maxx3105/HBW-IO-12-FM/Pictures/HBW-IO-12-FM_Bottom.png

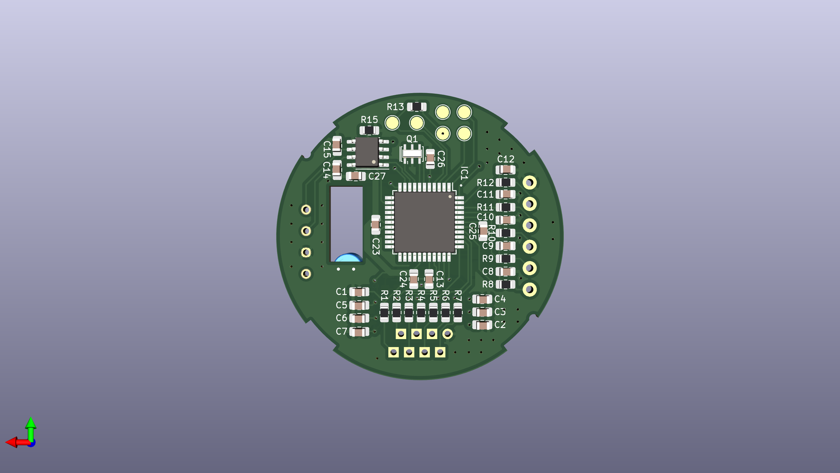
Pictures/HBW-IO-12-FM_Bottom.png
