maxx3105/HBW-IO-12-FM/README.md

# HBW-IO-12-FM
Homematic Wired Modul mit 12 Ein- oder Ausgängen
