maxx3105/HBW-IO-12-FM/Pictures/20240313_112604.jpg

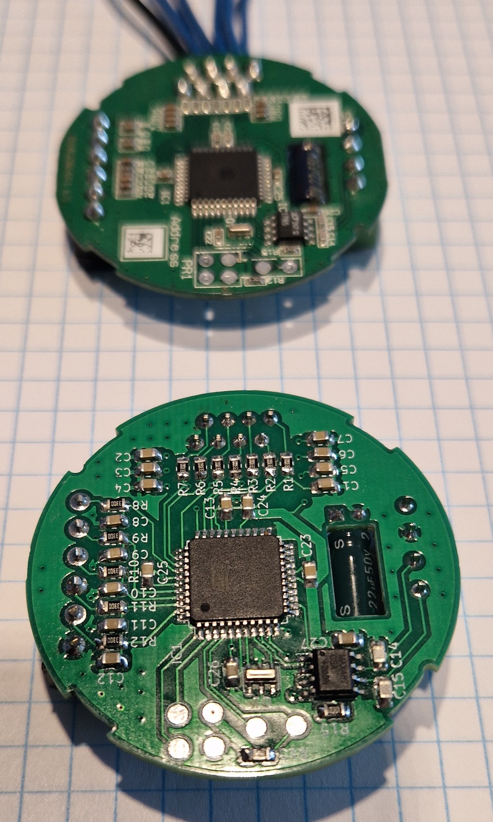
Pictures/20240313_112604.jpg
