maxx3105/HBW-IO-12-FM/Case/HBW-IO-12-FM_Cover.stl

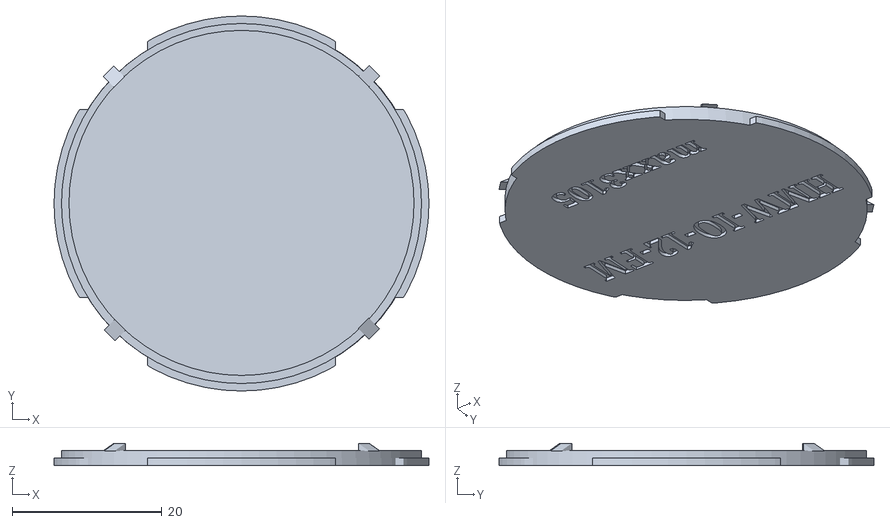
[picture p4: CAD file, 2024-02-26]
Case/HBW-IO-12-FM_Cover.stl
50.0 x 50.0 x 3.00
