maxx3105/HBW-IO-12-FM/Case/HBW-IO-12-FM_Body.stl

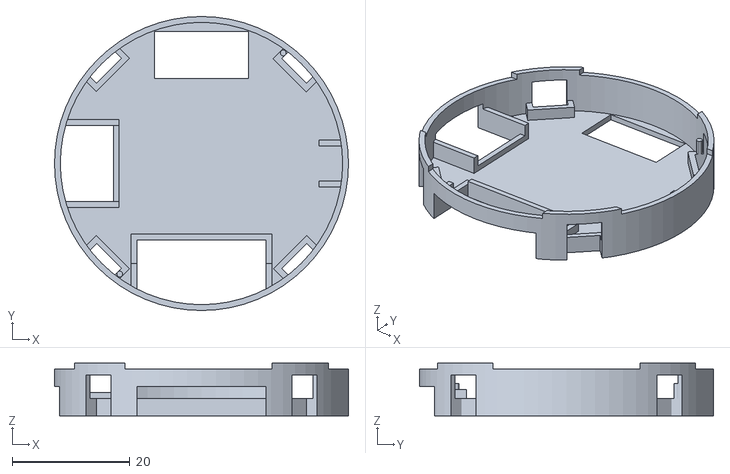
[picture p5: CAD file, 2024-02-26]
Case/HBW-IO-12-FM_Body.stl
50.0 x 50.0 x 9.00
