maxx3105/HBW-IO-12-FM/HBW-IO-12-FM.pdf

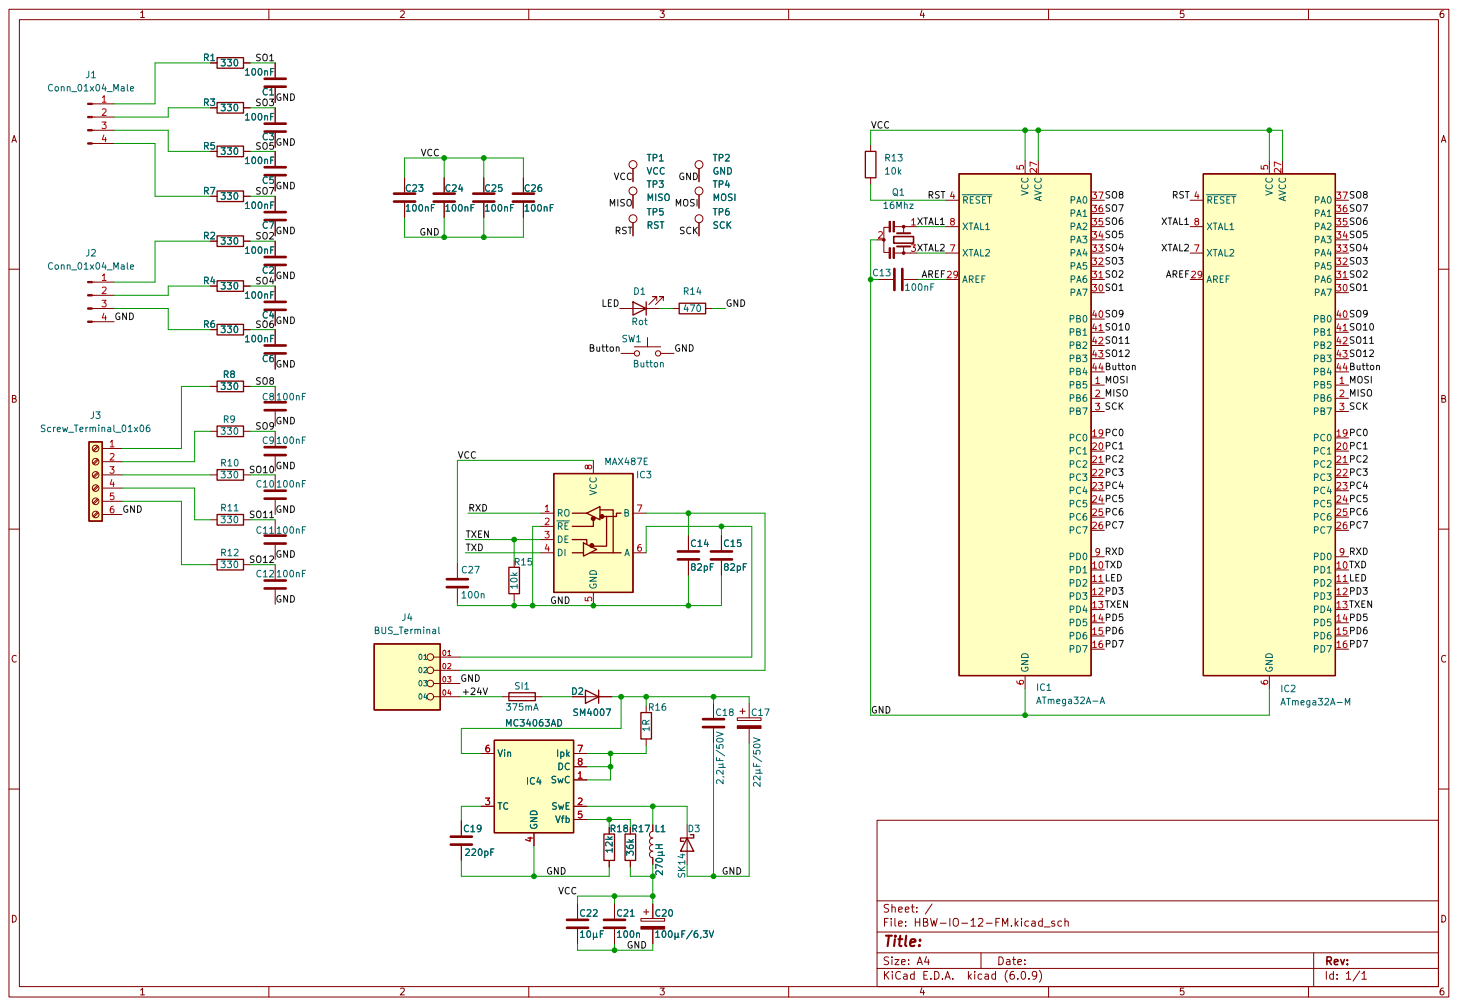
[picture p6: page 1]

File: HBW-IO-12-FM.kicad_sch Sheet: /
