maxx3105/HBW-IO-12-FM/HBW-IO-12-FM.kicad_pcb

## KiCad design HBW-IO-12-FM.kicad_pcb (2024-03-30)

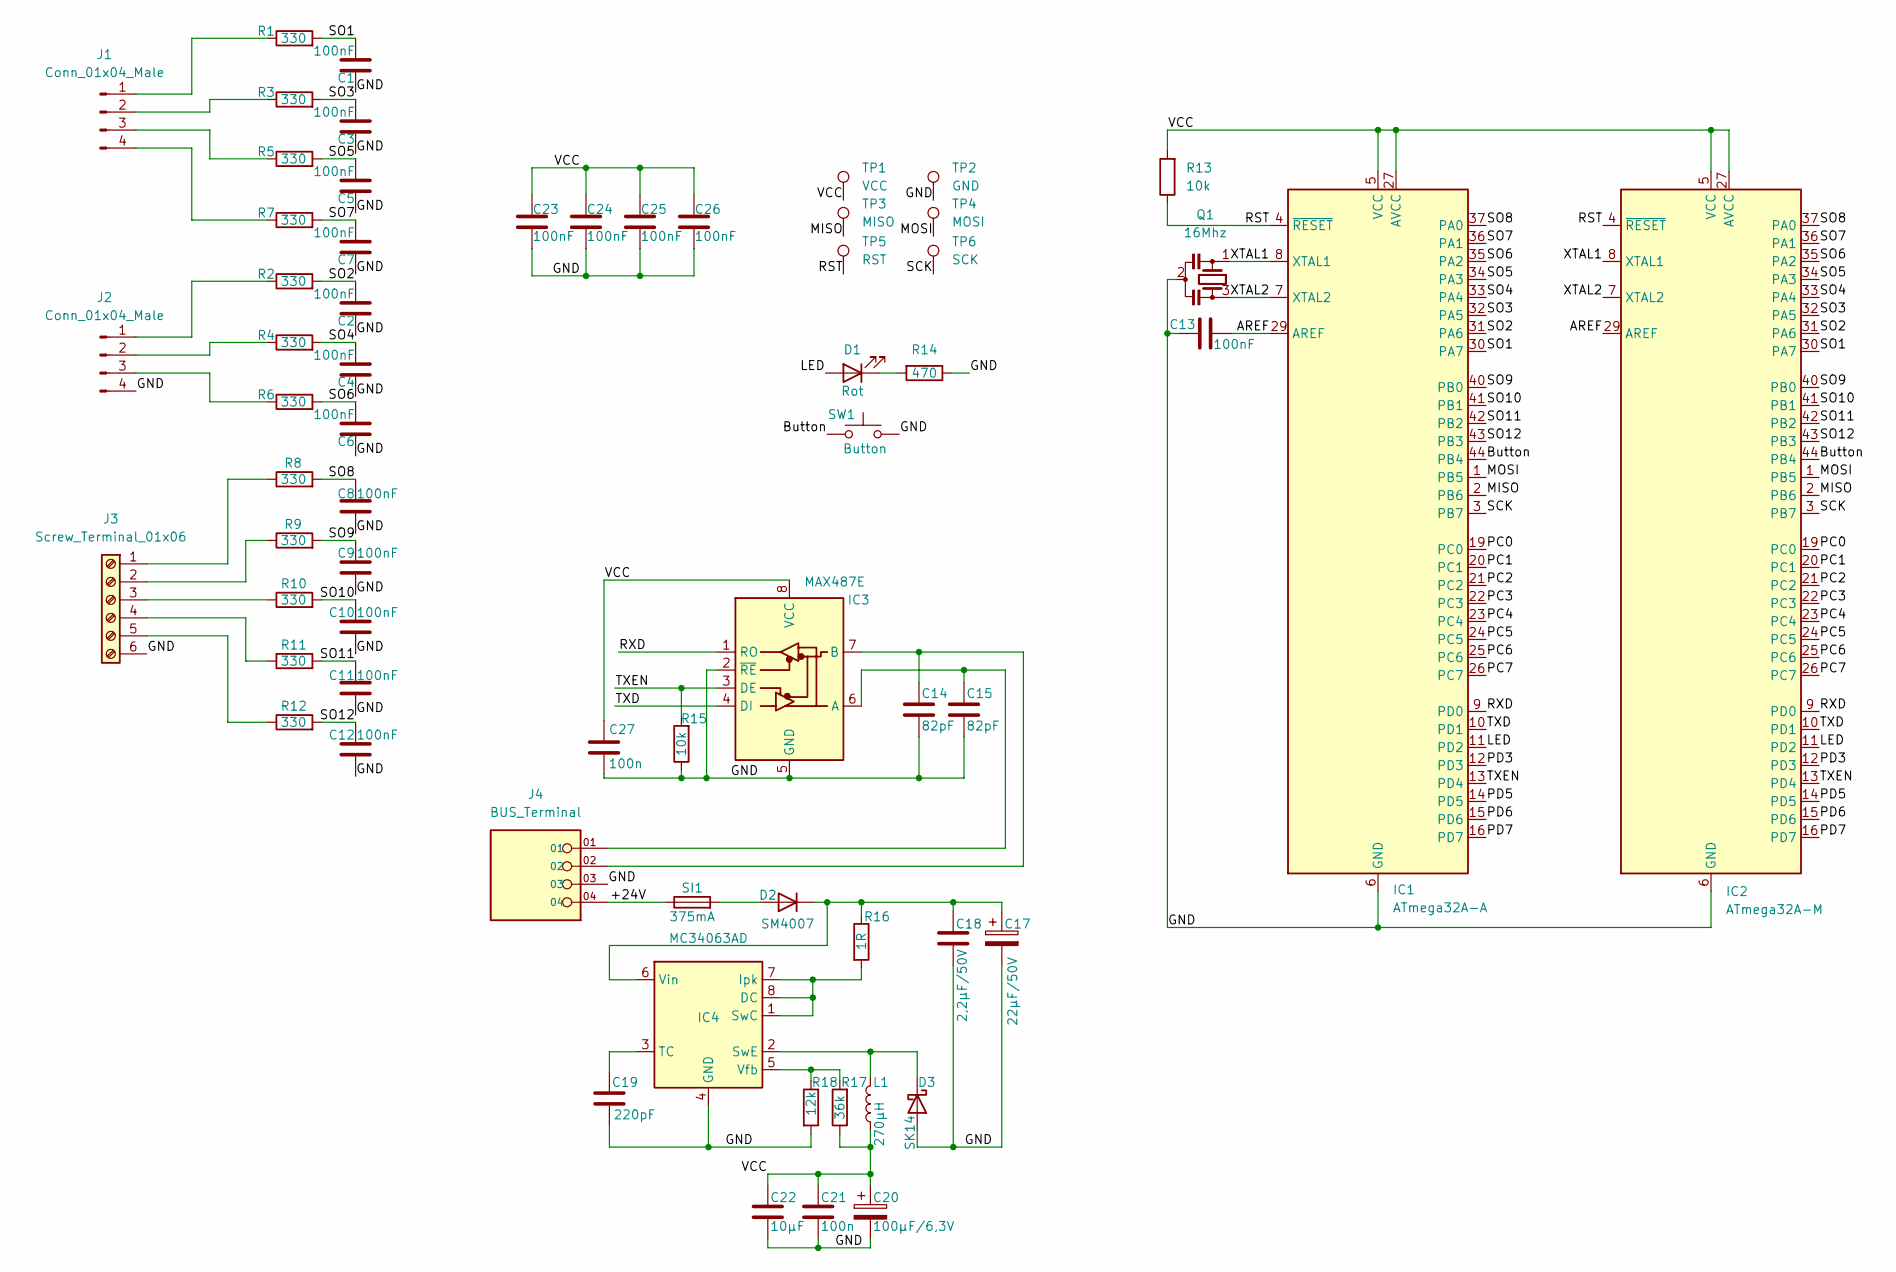
[picture p7: schematic HBW-IO-12-FM.kicad_sch]

Parts:
C1, C2, C3, C4, C5, C6, C7, C8, C9, C10, C11, C12, C13, C23, C24, C25, C26: 100nF; C_0805_2012Metric_Pad1.18x1.45mm_HandSolder
C14, C15: 82pF; C_0805_2012Metric_Pad1.18x1.45mm_HandSolder
C17: 22µF/50V; CP_Radial_D5.0mm_P2.50mm
C18: 2,2µF/50V; C_1210_3225Metric_Pad1.33x2.70mm_HandSolder
C19: 220pF; C_0805_2012Metric_Pad1.18x1.45mm_HandSolder
C20: 100µF/6,3V; CP_EIA-7343-20_Kemet-V_Pad2.25x2.55mm_HandSolder
C21, C27: 100n; C_0805_2012Metric_Pad1.18x1.45mm_HandSolder
C22: 10µF; C_1210_3225Metric_Pad1.33x2.70mm_HandSolder
D1: Rot; LED_0805_2012Metric_Pad1.15x1.40mm_HandSolder
D2: SM4007; D_MELF
D3: SK14; D_MELF
IC1: ATmega32A-A; TQFP-44_10x10mm_P0.8mm
IC2: ATmega32A-M; QFN-44-1EP_7x7mm_P0.5mm_EP5.2x5.2mm
IC3: MAX487E; SOIC-8_3.9x4.9mm_P1.27mm
IC4: MC34063AD; SOIC-8_3.9x4.9mm_P1.27mm
J1, J2: Conn_01x04_Male; PinHeader_1x04_P2.54mm_Vertical
J3: Screw_Terminal_01x06; TerminalBlock_MetzConnect_Type059_RT06306HBWC_1x06_P3.50mm_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
J4: BUS_Terminal; PHOENIX_1891085; PARTREV 11.03.2015
L1: 270µH; L_Taiyo-Yuden_MD-4040
Q1: 16Mhz; Resonator_SMD_Murata_CSTxExxV-3Pin_3.0x1.1mm_HandSoldering
R1, R2, R3, R4, R5, R6, R7, R8, R9, R10, R11, R12: 330; R_0805_2012Metric_Pad1.20x1.40mm_HandSolder
R13, R15: 10k; R_0805_2012Metric_Pad1.20x1.40mm_HandSolder
R14: 470; R_0805_2012Metric_Pad1.20x1.40mm_HandSolder
R16: 1R; R_0805_2012Metric_Pad1.20x1.40mm_HandSolder
R17: 36k; R_0805_2012Metric_Pad1.20x1.40mm_HandSolder
R18: 12k; R_0805_2012Metric_Pad1.20x1.40mm_HandSolder
SI1: 375mA; FUSC6127X294N
SW1: Button; SW_Push_1P1T_NO_CK_KMR2
TP1: VCC; TestPoint_Pad_D2.0mm
TP2: GND; TestPoint_Pad_D2.0mm
TP3: MISO; TestPoint_Pad_D2.0mm
TP4: MOSI; TestPoint_Pad_D2.0mm
TP5: RST; TestPoint_Pad_D2.0mm
TP6: SCK; TestPoint_Pad_D2.0mm

Connections:
/+24V: J4.04, SI1.1
/AREF: C13.2, IC1.29 (AREF), IC2.29 (AREF)
/Button: IC1.44 (PB4), IC2.44 (PB4), SW1.1
/GND: C1.1, C2.1, C3.1, C4.1, C5.1, C6.1, C7.1, C8.1, C9.1, C10.1, C11.1, C12.1, C13.1, C14.2, C15.2, C17.2, C18.2, C19.2, C20.2, C21.1, C22.2, C23.2, C24.2, C25.2, C26.2, C27.1, D3.2 (A), IC1.6 (GND), IC1.18 (GND), IC1.28 (GND), IC1.39 (GND), IC2.6 (GND), IC2.18 (GND), IC2.28 (GND), IC2.39 (GND), IC2.45 (GND), IC3.2 (~RE), IC3.5 (GND), IC4.4 (GND), J2.4, J3.6, J4.03, Q1.2, R14.1, R15.1, R18.2, SW1.2, TP2.1
/LED: D1.2 (A), IC1.11 (PD2), IC2.11 (PD2)
/MISO: IC1.2 (PB6), IC2.2 (PB6), TP3.1
/MOSI: IC1.1 (PB5), IC2.1 (PB5), TP4.1
/PC0: IC1.19 (PC0), IC2.19 (PC0)
/PC1: IC1.20 (PC1), IC2.20 (PC1)
/PC2: IC1.21 (PC2), IC2.21 (PC2)
/PC3: IC1.22 (PC3), IC2.22 (PC3)
/PC4: IC1.23 (PC4), IC2.23 (PC4)
/PC5: IC1.24 (PC5), IC2.24 (PC5)
/PC6: IC1.25 (PC6), IC2.25 (PC6)
/PC7: IC1.26 (PC7), IC2.26 (PC7)
/PD3: IC1.12 (PD3), IC2.12 (PD3)
/PD5: IC1.14 (PD5), IC2.14 (PD5)
/PD6: IC1.15 (PD6), IC2.15 (PD6)
/PD7: IC1.16 (PD7), IC2.16 (PD7)
/RST: IC1.4 (~RESET), IC2.4 (~RESET), R13.1, TP5.1
/RXD: IC1.9 (PD0), IC2.9 (PD0), IC3.1 (RO)
/SCK: IC1.3 (PB7), IC2.3 (PB7), TP6.1
/SO1: C1.2, IC1.30 (PA7), IC2.30 (PA7), R1.2
/SO2: C2.2, IC1.31 (PA6), IC2.31 (PA6), R2.2
/SO3: C3.2, IC1.32 (PA5), IC2.32 (PA5), R3.2
/SO4: C4.2, IC1.33 (PA4), IC2.33 (PA4), R4.2
/SO5: C5.2, IC1.34 (PA3), IC2.34 (PA3), R5.2
/SO6: C6.2, IC1.35 (PA2), IC2.35 (PA2), R6.2
/SO7: C7.2, IC1.36 (PA1), IC2.36 (PA1), R7.2
/SO8: C8.2, IC1.37 (PA0), IC2.37 (PA0), R8.2
/SO9: C9.2, IC1.40 (PB0), IC2.40 (PB0), R9.2
/SO10: C10.2, IC1.41 (PB1), IC2.41 (PB1), R10.2
/SO11: C11.2, IC1.42 (PB2), IC2.42 (PB2), R11.2
/SO12: C12.2, IC1.43 (PB3), IC2.43 (PB3), R12.2
/TXD: IC1.10 (PD1), IC2.10 (PD1), IC3.4 (DI)
/TXEN: IC1.13 (PD4), IC2.13 (PD4), IC3.3 (DE), R15.2
/VCC: C20.1, C21.2, C22.1, C23.1, C24.1, C25.1, C26.1, C27.2, IC1.5 (VCC), IC1.17 (VCC), IC1.27 (AVCC), IC1.38 (VCC), IC2.5 (VCC), IC2.17 (VCC), IC2.27 (AVCC), IC2.38 (VCC), IC3.8 (VCC), L1.1, R13.2, R17.1, TP1.1
/XTAL1: IC1.8 (XTAL1), IC2.8 (XTAL1), Q1.1
/XTAL2: IC1.7 (XTAL2), IC2.7 (XTAL2), Q1.3
unnamed: C14.1, IC3.7 (B), J4.02
unnamed: C15.1, IC3.6 (A), J4.01
unnamed: C17.1, C18.1, D2.1 (K), IC4.6 (Vin), R16.1
unnamed: C19.1, IC4.3 (TC)
unnamed: D1.1 (K), R14.2
unnamed: D2.2 (A), SI1.2
unnamed: D3.1 (K), IC4.2 (SwE), L1.2
unnamed: IC4.1 (SwC), IC4.7 (Ipk), IC4.8 (DC), R16.2
unnamed: IC4.5 (Vfb), R17.2, R18.1
unnamed: J1.1, R1.1
unnamed: J1.2, R3.1
unnamed: J1.3, R5.1
unnamed: J1.4, R7.1
unnamed: J2.1, R2.1
unnamed: J2.2, R4.1
unnamed: J2.3, R6.1
unnamed: J3.1, R8.1
unnamed: J3.2, R9.1
unnamed: J3.3, R10.1
unnamed: J3.4, R11.1
unnamed: J3.5, R12.1

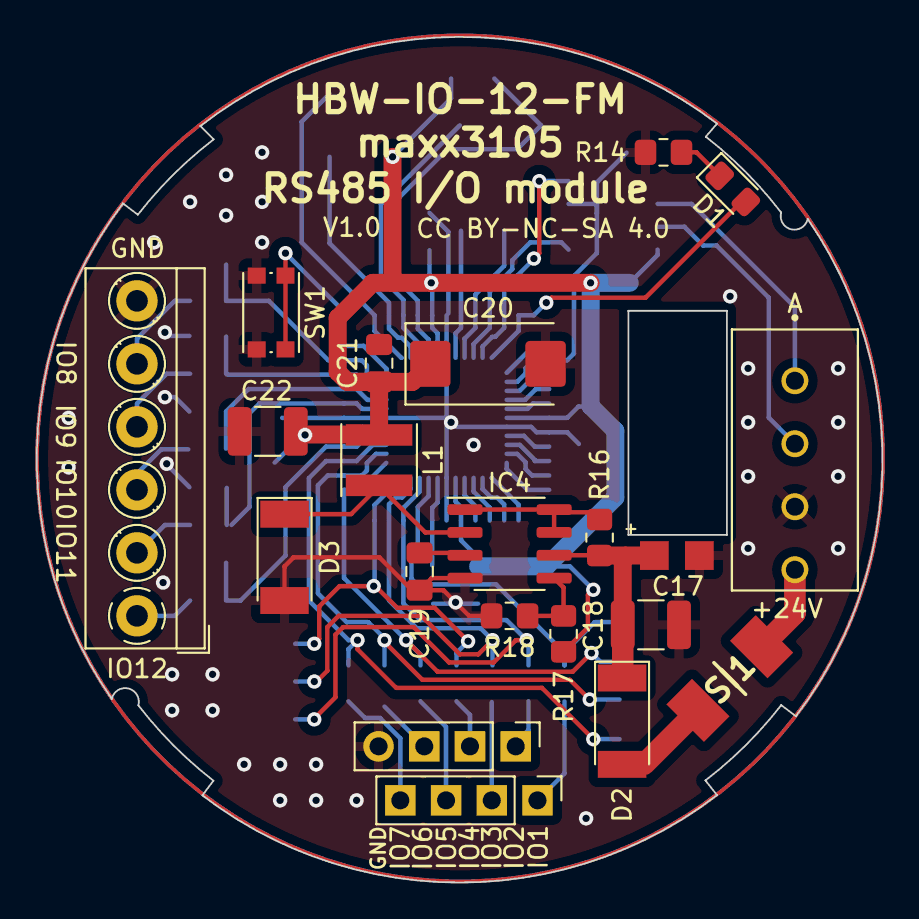
[picture p8: board HBW-IO-12-FM.kicad_pcb from above]

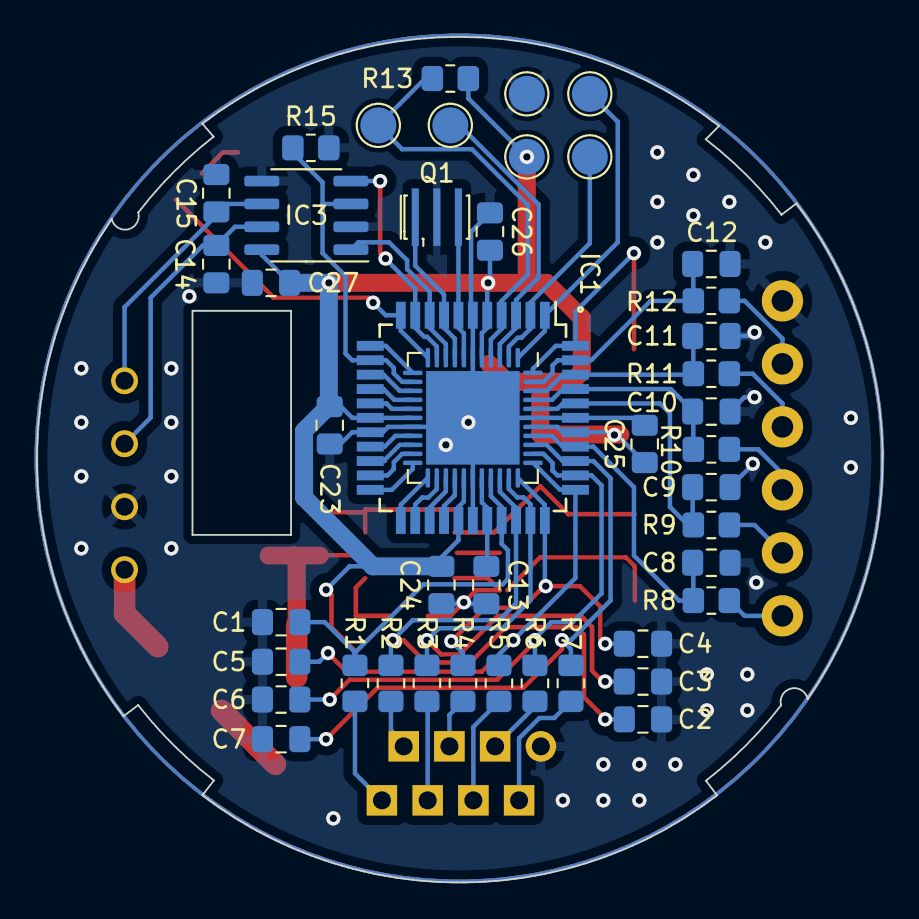
[picture p9: board HBW-IO-12-FM.kicad_pcb from below]

Board: 2 copper layers, 47.0 x 47.0 mm, 65 parts (44 on the bottom side), 60 nets.
