maxx3105/HBW-IO-12-FM/Firmware/HBW-IO-12-FM/HBW-IO-12-FM_config.h

/* Pin- und Hardware-Konfiguration für HBW-IO-12-FM
 *
 * Unterstützte Mikrocontroller (jeweils im Standard-Pinout der gängigen Cores):
 *   - ATmega328P     (Arduino IDE / "Arduino Nano/Uno")
 *   - ATmega32(A)    (MightyCore "Standard" pinout)        <-- HW-Ziel HBW-IO-12-FM
 *   - ATmega644P(A)  (MightyCore "Standard" pinout)
 *   - ATmega1284P    (MightyCore "Standard" pinout)
 *
 * MightyCore-Standard-Pinout (32/644/1284):
 *   PB0..PB7 = 0..7    (LED_BUILTIN = 7)
 *   PD0..PD7 = 8..15   (8=RX0, 9=TX0, 10=RX1, 11=TX1 -- nur 644P/1284P)
 *   PC0..PC7 = 16..23
 *   PA0..PA7 = 24..31  (= A0..A7)
 *
 * WICHTIG: Die Pin-Zuordnung der 12 IOs muss gegen den Schaltplan der
 * konkreten Platine geprüft werden!
 *   https://github.com/maxx3105/HBW-IO-12-FM/blob/main/HBW-IO-12-FM.pdf
 */

#ifndef HBW_IO_12_FM_CONFIG_H
#define HBW_IO_12_FM_CONFIG_H

#include <Arduino.h>
#include <EEPROM.h>
#include "FreeRam.h"

EEPROMClass* EepromPtr = &EEPROM;   // internes EEPROM

// ============================================================================
// ATmega328P  (Arduino Nano / Pro Mini / Uno -- ein UART)
// ============================================================================
#if defined(__AVR_ATmega328P__) || defined(__AVR_ATmega328__)

  // RS485 standardmäßig per SoftwareSerial, UART0 für USB-Debug.
  // Definiere USE_HARDWARE_SERIAL (z.B. via -DUSE_HARDWARE_SERIAL), um
  // RS485 auf den Hardware-UART zu legen (dann kein Debug verfügbar).

  #define IO1   A3
  #define IO2   10
  #define IO3   11
  #define IO4   A0
  #define IO5   A1
  #define IO6   A2
  #define IO7   A4
  #define IO8   A5
  #define IO9    9
  #define IO10   7
  #define IO11   6
  #define IO12   5

  #define LED   LED_BUILTIN     // D13

  #ifdef USE_HARDWARE_SERIAL
    #define RS485_TXEN  2
    #define BUTTON      A6
    #define HBW_RS485       (Serial)
    #define HBW_DEBUGSTREAM (NULL)
    #define HBW_BEGIN_SERIALS() do { Serial.begin(19200, SERIAL_8E1); } while (0)
  #else
    #define RS485_RXD   4
    #define RS485_TXD   2
    #define RS485_TXEN  3
    #define BUTTON      8

    #include <HBWSoftwareSerial.h>
    HBWSoftwareSerial rs485(RS485_RXD, RS485_TXD);
    #define HBW_RS485       (rs485)
    #define HBW_DEBUGSTREAM (&Serial)
    #define HBW_BEGIN_SERIALS() do { Serial.begin(115200); rs485.begin(19200); } while (0)
  #endif

// ============================================================================
// ATmega32 / ATmega32A  (MightyCore -- ein UART, kein Serial1)
// ============================================================================
#elif defined(__AVR_ATmega32__) || defined(__AVR_ATmega32A__)

  // 12 IOs: PA7..PA0 (31..24) + PB0..PB3 (0..3)  -- an die Hardware angepasst
  #define IO1   31    // PA7
  #define IO2   30    // PA6
  #define IO3   29    // PA5
  #define IO4   28    // PA4
  #define IO5   27    // PA3
  #define IO6   26    // PA2
  #define IO7   25    // PA1
  #define IO8   24    // PA0
  #define IO9   0     // PB0
  #define IO10  1     // PB1
  #define IO11  2     // PB2
  #define IO12  3     // PB3

  #define LED   10    // PD2 
  #define BUTTON      4       // PB4
  // -- RS485 auf Hardware-UART:  RO -> Pin 8 (PD0/RX0),  DI -> Pin 9 (PD1/TX0) --
  #define RS485_TXEN  12        // PD4  -> Transceiver DE (+ /RE zusammen)
  #define HBW_RS485       (Serial)
  #define HBW_DEBUGSTREAM (NULL)
  #define HBW_BEGIN_SERIALS() do { Serial.begin(19200, SERIAL_8E1); } while (0)


// ============================================================================
// ATmega644P(A) / ATmega1284P  (MightyCore -- pinkompatibel zum 32A)
// ============================================================================
#elif defined(__AVR_ATmega644P__)  || defined(__AVR_ATmega644PA__) \
   || defined(__AVR_ATmega1284P__) || defined(__AVR_ATmega1284__)

  // Pinkompatibel zum 32A (selbe Platine) -> identische Belegung.
  // RS485 deshalb auch hier auf dem ERSTEN UART (Serial/PD0/PD1), NICHT Serial1:
  // dessen RX1 ist PD2, und PD2 ist die LED. -> kein Geraete-Debug (UART = Bus,
  // wie 32A). Vorteil 644P/1284P: groesseres EEPROM (Adresse weit ueber den
  // Links, keine 30-Input-Link-Ueberlapp-Frage wie auf dem 1KB-32A).
  // 12 IOs: PA7..PA0 (31..24) + PB0..PB3 (0..3)
  #define IO1   31    // PA7
  #define IO2   30    // PA6
  #define IO3   29    // PA5
  #define IO4   28    // PA4
  #define IO5   27    // PA3
  #define IO6   26    // PA2
  #define IO7   25    // PA1
  #define IO8   24    // PA0
  #define IO9   0     // PB0
  #define IO10  1     // PB1
  #define IO11  2     // PB2
  #define IO12  3     // PB3

  #define LED          10       // PD2
  #define BUTTON       4        // PB4
  #define RS485_TXEN   12       // PD4  -> Transceiver DE (+ /RE zusammen)
  #define HBW_RS485       (Serial)        // RS485 auf UART0 (PD0/RX0, PD1/TX0), wie 32A
  #define HBW_DEBUGSTREAM (NULL)
  #define HBW_BEGIN_SERIALS() do { Serial.begin(19200, SERIAL_8E1); } while (0)

#else
  #error "HBW-IO-12-FM: Nicht unterstuetzter Mikrocontroller. Erlaubt: ATmega328P, ATmega32(A), ATmega644P(A), ATmega1284P."
#endif

#endif  // HBW_IO_12_FM_CONFIG_H
