maxx3105/HBW-IO-12-FM/(commit log)

2024-03-13 Add files via upload
    Bigger hole for tht capacitor.
    [HMW-IO-12-FM-B_Cu.gbr, HMW-IO-12-FM-B_Mask.gbr, HMW-IO-12-FM-B_Paste.gbr, HMW-IO-12-FM-B_Silkscreen.gbr, HMW-IO-12-FM-Edge_Cuts.gbr, HMW-IO-12-FM-F_Cu.gbr, HMW-IO-12-FM-F_Mask.gbr, HMW-IO-12-FM-F_Paste.gbr]
2024-03-26 Add button for firmware reset.
    [HMW-IO-12-FM-B_Cu.gbr, HMW-IO-12-FM-B_Mask.gbr, HMW-IO-12-FM-B_Paste.gbr, HMW-IO-12-FM-B_Silkscreen.gbr, HMW-IO-12-FM-Edge_Cuts.gbr, HMW-IO-12-FM-F_Cu.gbr, HMW-IO-12-FM-F_Mask.gbr, HMW-IO-12-FM-F_Paste.gbr]
2026-06-23 Firmware (HBW-IO-12-FM): HBWired-Klon-Firmware fuer ATmega32A
    1:1-Klon-Firmware fuer das HMW-IO-12-FM auf dem loetmeister-HBWired-Fork:
    - HBWSwitchHM/HBWLinkSwitchHM: originalgetreues 28-Byte-Output-Peering
    (2-Byte-HM-config-time) statt loetmeister-20-Byte-Kompaktformat
    - HBWChanIn: Input-Kanal exakt nach Original-XML-Layout
    - 32A auf Hardware-UART, 8E1 (SoftwareSerial-RX geht auf dem 32A nicht)
    - HARDWARE_VERSION=0 (= supported_types index1 -> als HMW-IO-12-FM erkannt),
    FIRMWARE_VERSION=0x0300 (meldet 3.00 wie Original, kein Update-Angebot)
    - Auto-Reset bei BEHAVIOUR-Aenderung (INPUT<->OUTPUT), entprellt
    [HBW-IO-12-FM.ino, HBW-IO-12-FM_config.h]
2026-06-23 Refactor pin definitions for LED and BUTTON
2026-06-24 Refactor IO pin definitions and RS485 settings
2026-06-25 Firmware: CCU-Sim loest Direktverknuepfungen, Werksreset-Defaults, BEHAVIOUR-Fix
    - receiveKeyEvent(): CCU-KEY-Sim (Anlerntest) loest interne UND externe
    Direktverknuepfungen aus wie ein echter Taster -- via eigenem LinkSender
    (CCU-Absender wurde sonst nie gegen die eigene Sensor-Adresse gematcht).
    - BEHAVIOUR: "frisch" jetzt ueber central_address erkannt statt ueber 0xFFFF.
    Die gueltige Konfig "alle 12 OUTPUT" (=0xFFFF) wurde sonst verworfen und
    kein Ausgang schaltete.
    - Werksreset-Defaults persistent ins EEPROM: LOGGING_TIME (0x01=20 -> 2.0 s,
    statt 0xFF=25.5 s) und BEHAVIOUR (0x07/0x08 -> alle INPUT, statt 0xFF/0xFF
    = von der CCU faelschlich als alle OUTPUT angezeigt).
    - HBWSwi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
    [HBW-IO-12-FM.ino, HBW-IO-12-FM_config.h]
