maxx3105/HBW-IO-12-FM/(notices)

Notices in the files:
HBW-IO-12-FM.kicad_pcb:
CC BY-NC-SA 4.0
